milosavljevic92/aquadecor-embedded/aqualight_v3/PCB/aqualight_v3_full.png

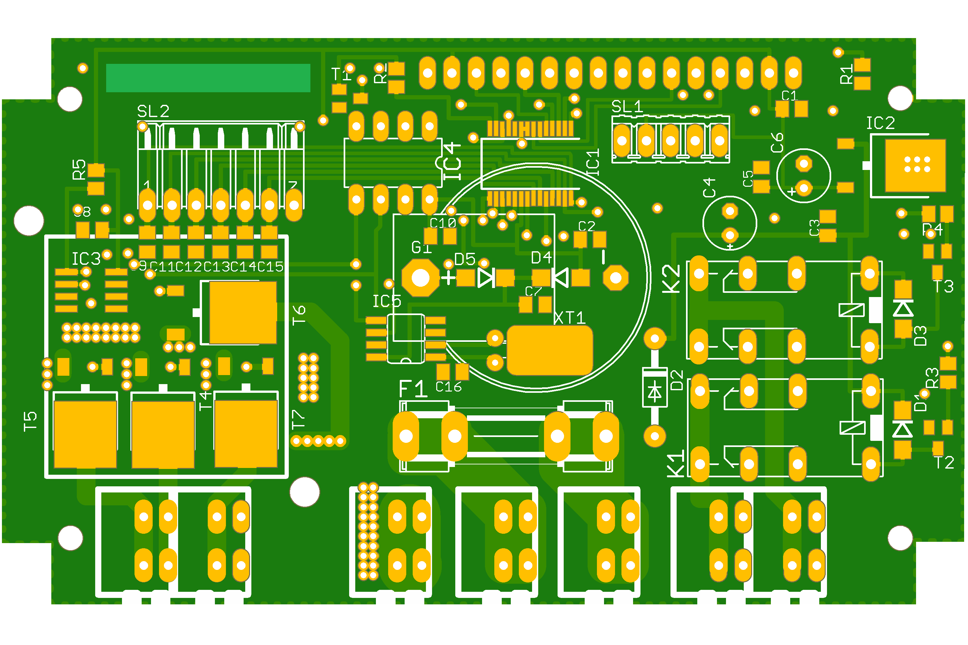
aqualight_v3/PCB/aqualight_v3_full.png
