milosavljevic92/aquadecor-embedded/aqualight_v3/PICTURES/DSC_0008.jpg

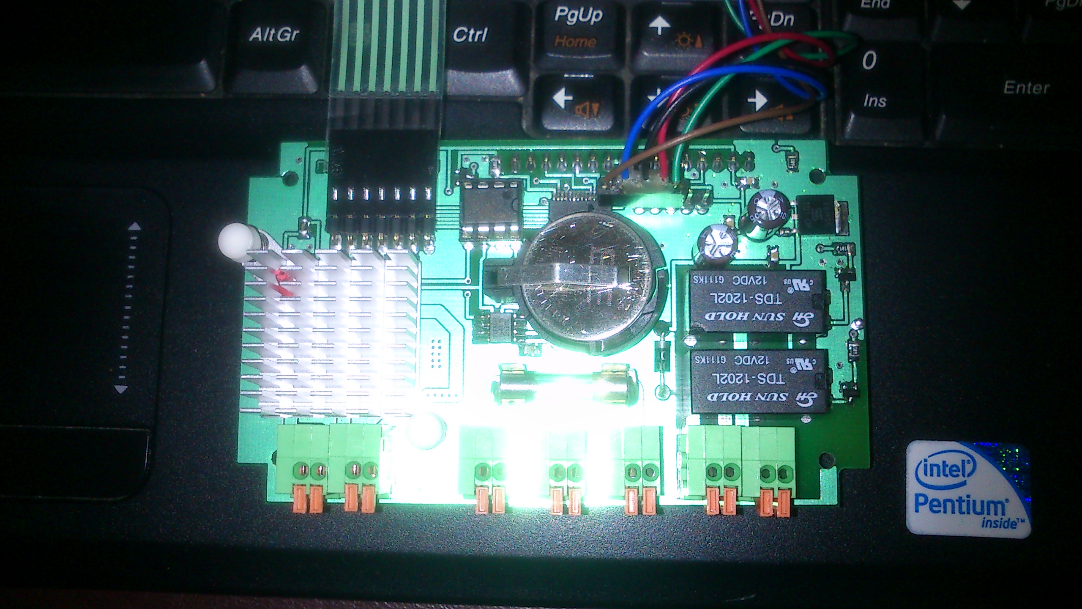
aqualight_v3/PICTURES/DSC_0008.jpg
