milosavljevic92/aquadecor-embedded/aqualight_v3/PICTURES/DSC_0034.jpg

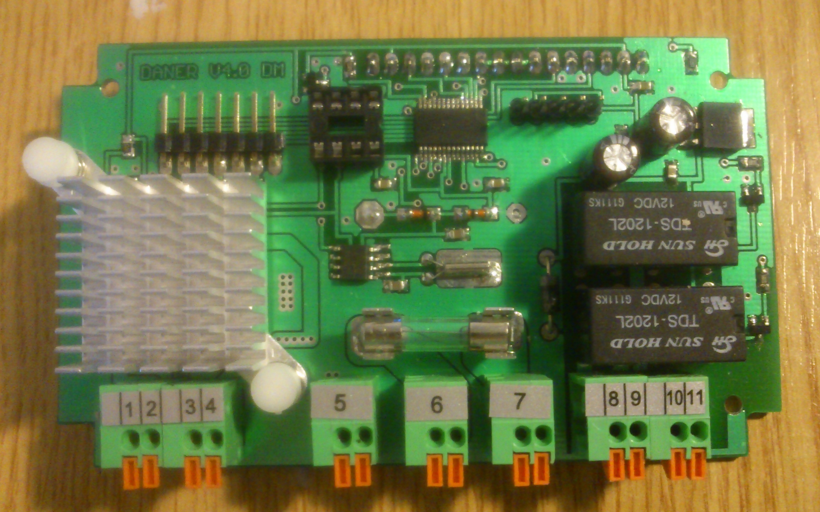
aqualight_v3/PICTURES/DSC_0034.jpg
