milosavljevic92/aquadecor-embedded/aqualight_v3/PICTURES/DSC_0325.jpg

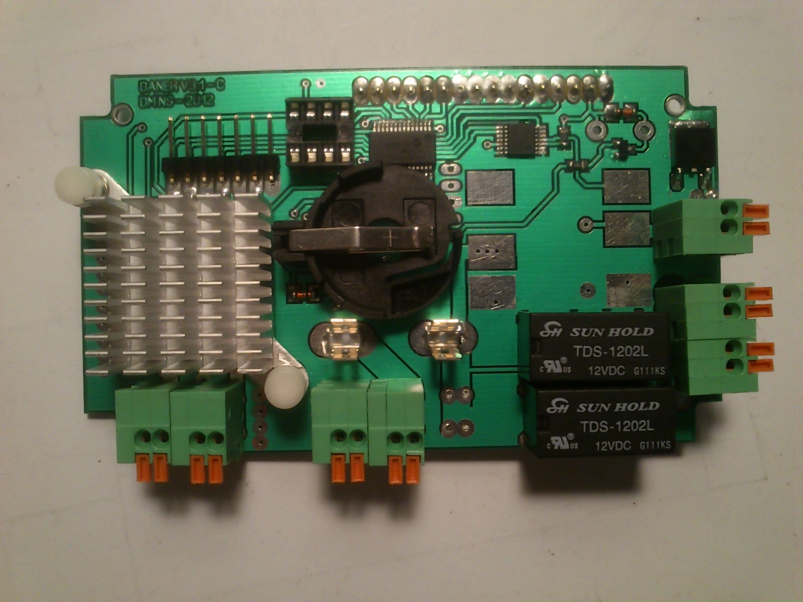
aqualight_v3/PICTURES/DSC_0325.jpg
