milosavljevic92/aquadecor-embedded/aqualight_v3/aqualight_v3_part_list.xlsx

 | Type | Part name | Quantity
IC
1 | IC | PIC18F25k22 SSOP | 1 | 0.00 Din.
2 | IC | PCF8563 SO8 | 1
3 | IC | LM75 SO8 | 1
4 | IC | 24C64 DIP | 1
SMD PART
5 | IC | 78M05 TO252 | 1
6 | Resistor | SMD0805 680 Ohm | 4
7 | Diod | SMD0805 1n41418 | 4
8 | Resistor | SMD0805 4,7k | 1
9 | Transistor | SMD BC517 | 3
10 | Capacitor | SMD0805 100nF | 11
11 | Mosfet | IRLR 8721 TO252 | 4
12 | Capacitor | SMD0805 12Pf | 1
Other part
13 | Battery | CR2032 | 1
14 | Battery holder | Battery holder CR2032 | 1
15 | Diod | 1N4007 | 1
16 | Capacitor | 100uF / 16v ELKO | 2
17 | Relay | Relay HJR1-2C-L-12VDC 2XU 12V 2A 720R | 2
18 | Crystal | Crystal 32,768kHz 2x6 mm | 1
19 | Dil | Chip 8pin DIL8 | 1
20 | Fuse | Fuse fast 10A | 1
21 | Fuse holder | Metal fuse holder - one side | 2
22 | Connector | 2.54 male connector 1x7 angle | 1
23 | Connector | 2.54 male connector 1x5 | 1
24 | Connector | 2.54 male connector 1x16 | 1
25 | Disply | LCD display HD44780 2x16chr + blue backlight | 1
26 | Connector | Connector 2.54 screwless | 7
27 | PCB | PCB 100x60mm double-side | 1
28 | Heatsink | Heatsink Al 26x26mm with spring | 1
