milosavljevic92/aquadecor-embedded/aqualight_v3/PCB/aqualight_v3_full.dxf

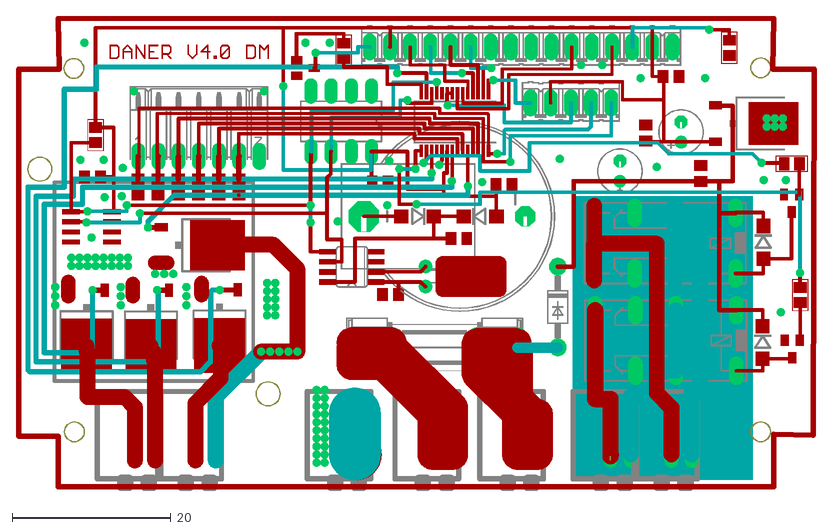
[picture p7: CAD file, 2026-06-04]
aqualight_v3/PCB/aqualight_v3_full.dxf
100.7 x 59.7
