milosavljevic92/aquadecor-embedded/aqualight_v3/Usermanual/MENU_TREE.pdf

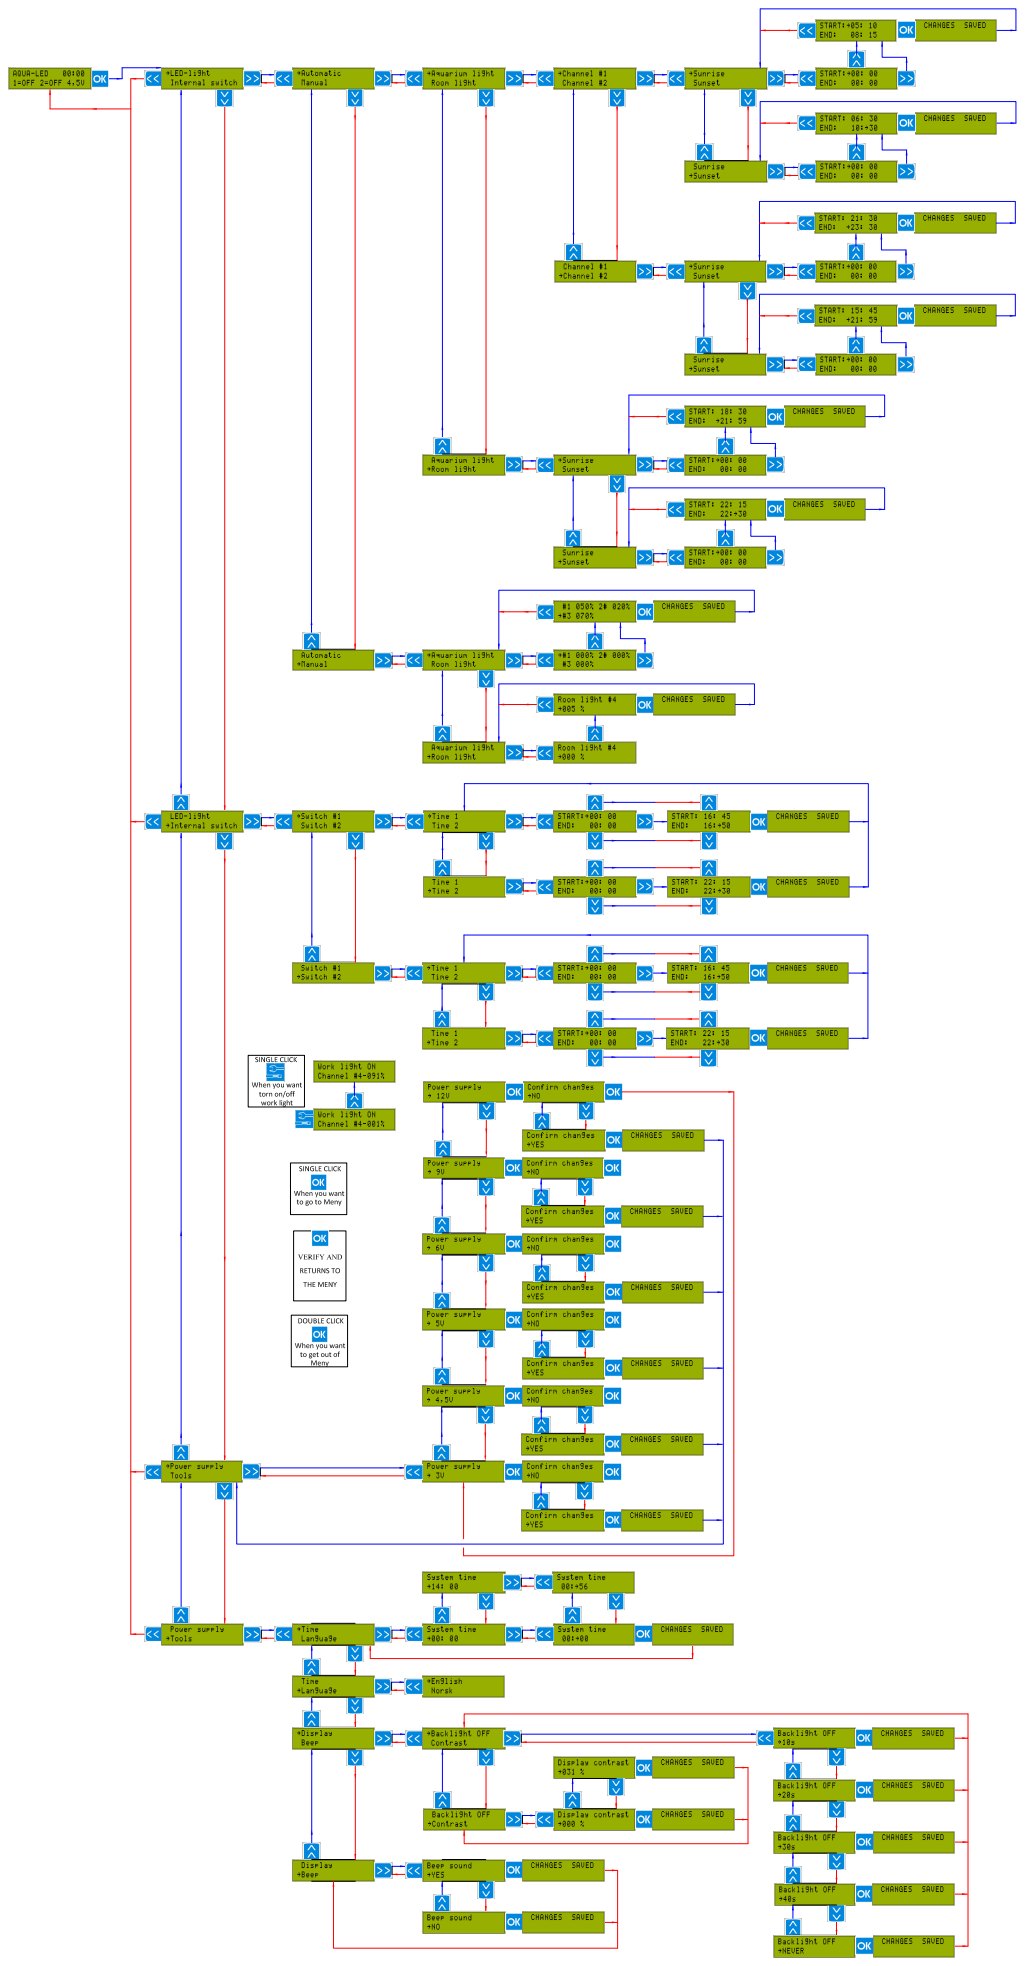
[picture p8: page 1]
