milosavljevic92/aquadecor-embedded/(list of files, drawings)

Other design files:
aqualight_v1/PCB/aqualight_v1_MAIN_pcb.LAY
aqualight_v2/PCB/aqualight_v2_LCD_pcb.LAY
aqualight_v2/PCB/aqualight_v2_MAIN_v2_pcb.LAY
aqualight_v3/Proteus-Simulation/Sim_aqualight_v3_menu.DSN
