milosavljevic92/aquadecor-embedded/aqualight_v3/PCB/aqualight_v3_full.brd

## EAGLE design aqualight_v3/PCB/aqualight_v3_full.brd (2026-06-04)

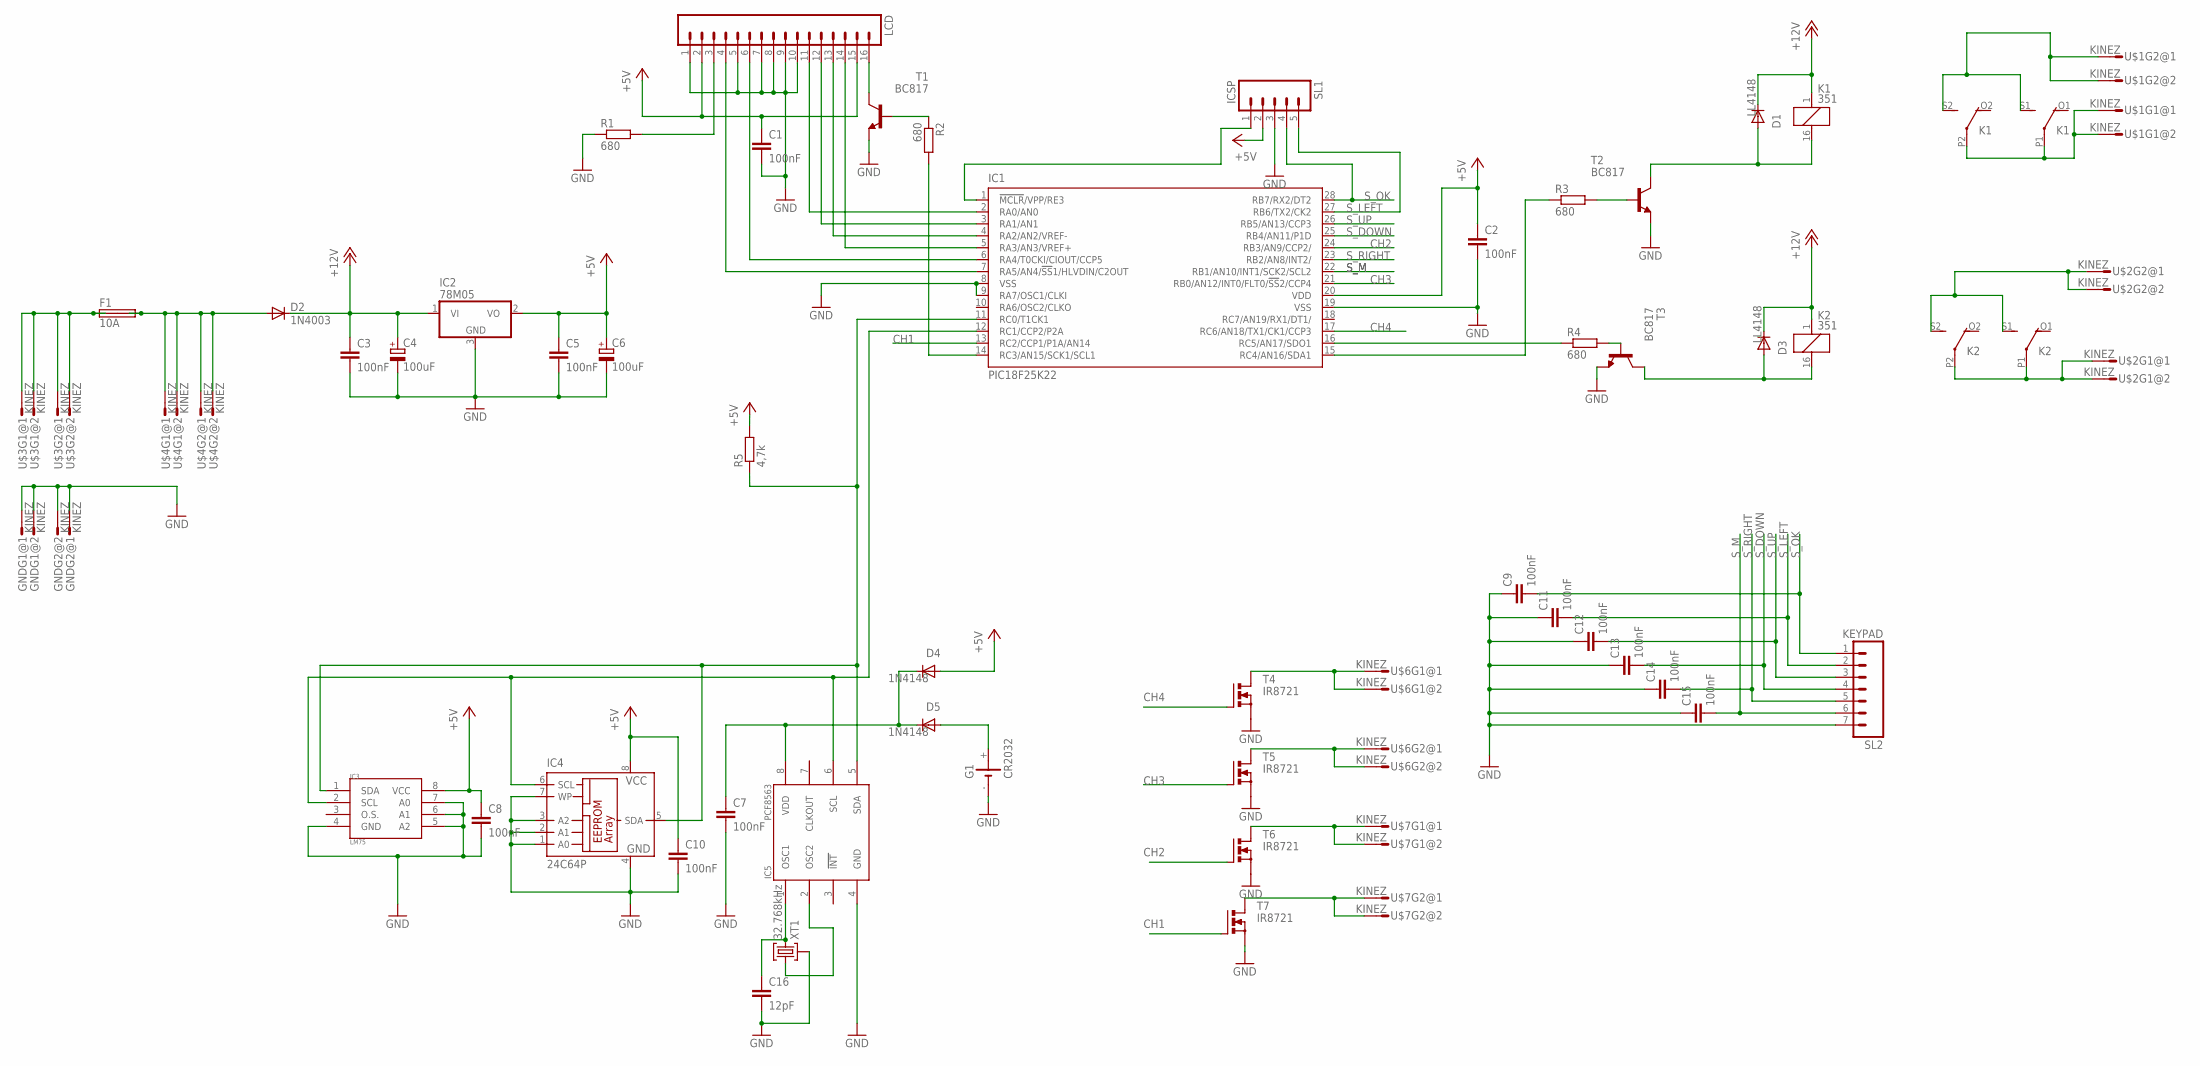
[picture p9: schematic aqualight_v3_full.sch]

Parts:
C1, C2, C3, C5, C7, C8, C9, C10, C11, C12, C13, C14, C15: 100nF; C0805K
C4: 100uF; E2,5-6E
C6: 100uF; E2,5-6
C16: 12pF; C0805K
D1, D3: LL4148; DO214BA
D2: 1N4003; DO41-10
D4, D5: 1N4148; DO214BA
F1: 10A; SHK20L
G1: CR2032
GND: KINEZ
IC1: PIC18F25K22; SSOP28
IC2: 78M05; TO252
IC3: LM75; SO08
IC4: 24C64P; DIL8
IC5: PCF8563; SO08
K1, K2: 351
LCD: M16; 16P
R1, R2, R3, R4: 680; M0805
R5: 4,7k; M0805
SL1: ICSP; 05P
SL2: KEYPAD; 07PA
T1, T2, T3: BC817; SOT23-BEC
T4, T5, T6, T7: IR8721; TO252
U$1, U$2, U$3, U$4, U$6, U$7: KINEZ
XT1: 32.768kHz; XTMINI

Connections:
+5V: C1.1, C2.1, C5.1, C6.+, C8.1, C10.1, D4.A, IC1.20 (VDD), IC2.2 (VO), IC3.8 (VCC), IC4.8 (VCC), LCD.2, LCD.15, R5.2, SL1.2
+12V: C3.1, C4.+, D1.C, D2.C, D3.C, IC2.1 (VI), K1.1, K2.1
CH1: IC1.13 (RC2/CCP1/P1A/AN14), T7.1 (G)
CH2: IC1.24 (RB3/AN9/CCP2/), T6.1 (G)
CH3: IC1.21 (RB0/AN12/INT0/FLT0/!SS!2/CCP4), T5.1 (G)
CH4: IC1.17 (RC6/AN18/TX1/CK1/CCP3), T4.1 (G)
GND: C1.2, C2.2, C3.2, C4.-, C5.2, C6.-, C7.2, C8.2, C9.1, C10.2, C11.1, C12.1, C13.1, C14.1, C15.1, C16.2, G1.-, GND.1, GND.2, GND.3, GND.4, IC1.8 (VSS), IC1.9 (RA7/OSC1/CLKI), IC1.19 (VSS), IC2.3 (GND), IC3.4 (GND), IC3.5 (A2), IC3.6 (A1), IC3.7 (A0), IC4.1 (A0), IC4.2 (A1), IC4.3 (A2), IC4.4 (GND), IC4.7 (WP), IC5.4 (GND), LCD.1, LCD.5, LCD.7, LCD.8, LCD.9, LCD.10, R1.1, SL1.3, SL2.7, T1.E, T2.E, T3.E, T4.3 (S), T5.3 (S), T6.3 (S), T7.3 (S), XT1.P$3 (3)
unnamed: D5.A, G1.+
unnamed: K1.S1 (S), K1.S2 (S), U$1.3, U$1.4
unnamed: K2.P1, K2.P2, U$2.1, U$2.2
unnamed: F1.1A, F1.1B, U$3.1, U$3.2, U$3.3, U$3.4
unnamed: D2.A, F1.2A, F1.2B, U$4.1, U$4.2, U$4.3, U$4.4
unnamed: IC1.15 (RC4/AN16/SDA1), R3.1
unnamed: IC5.2 (OSC2), XT1.P$1 (1)
unnamed: IC1.11 (RC0/T1CK1), IC3.1 (SDA), IC4.5 (SDA), IC5.5 (SDA), R5.1
unnamed: IC1.12 (RC1/CCP2/P2A), IC3.2 (SCL), IC4.6 (SCL), IC5.6 (SCL)
unnamed: C7.1, D4.C, D5.C, IC5.8 (VDD)
unnamed: IC1.2 (RA0/AN0), LCD.11
unnamed: IC1.3 (RA1/AN1), LCD.12
unnamed: IC1.4 (RA2/AN2/VREF-), LCD.13
unnamed: IC1.5 (RA3/AN3/VREF+), LCD.14
unnamed: IC1.6 (RA4/T0CKI/CIOUT/CCP5), LCD.6
unnamed: T5.2 (D), U$6.3, U$6.4
unnamed: IC1.7 (RA5/AN4/!SS!1/HLVDIN/C2OUT), LCD.4
unnamed: LCD.3, R1.2
unnamed: T6.2 (D), U$7.1, U$7.2
unnamed: T7.2 (D), U$7.3, U$7.4
unnamed: D1.A, K1.16 (2), T2.C
unnamed: C16.1, IC5.1 (OSC1), XT1.P$2 (2)
unnamed: D3.A, K2.16 (2), T3.C
unnamed: LCD.16, T1.C
unnamed: R4.2, T3.B
unnamed: R3.2, T2.B
unnamed: K1.P1, K1.P2, U$1.1, U$1.2
unnamed: IC1.16 (RC5/AN17/SDO1), R4.1
unnamed: R2.1, T1.B
unnamed: IC1.14 (RC3/AN15/SCK1/SCL1), R2.2
unnamed: T4.2 (D), U$6.1, U$6.2
unnamed: IC1.1 (!MCLR!/VPP/RE3), SL1.1
SWITCH2_IN: K2.S1 (S), K2.S2 (S), U$2.3, U$2.4
S_DOWN: C13.2, IC1.25 (RB4/AN11/P1D), SL2.4
S_LEFT: C11.2, IC1.27 (RB6/TX2/CK2), SL1.5, SL2.2
S_M: C15.2, IC1.22 (RB1/AN10/INT1/SCK2/SCL2), SL2.6
S_OK: C9.2, IC1.28 (RB7/RX2/DT2), SL1.4, SL2.1
S_RIGHT: C14.2, IC1.23 (RB2/AN8/INT2/), SL2.5
S_UP: C12.2, IC1.26 (RB5/AN13/CCP3), SL2.3

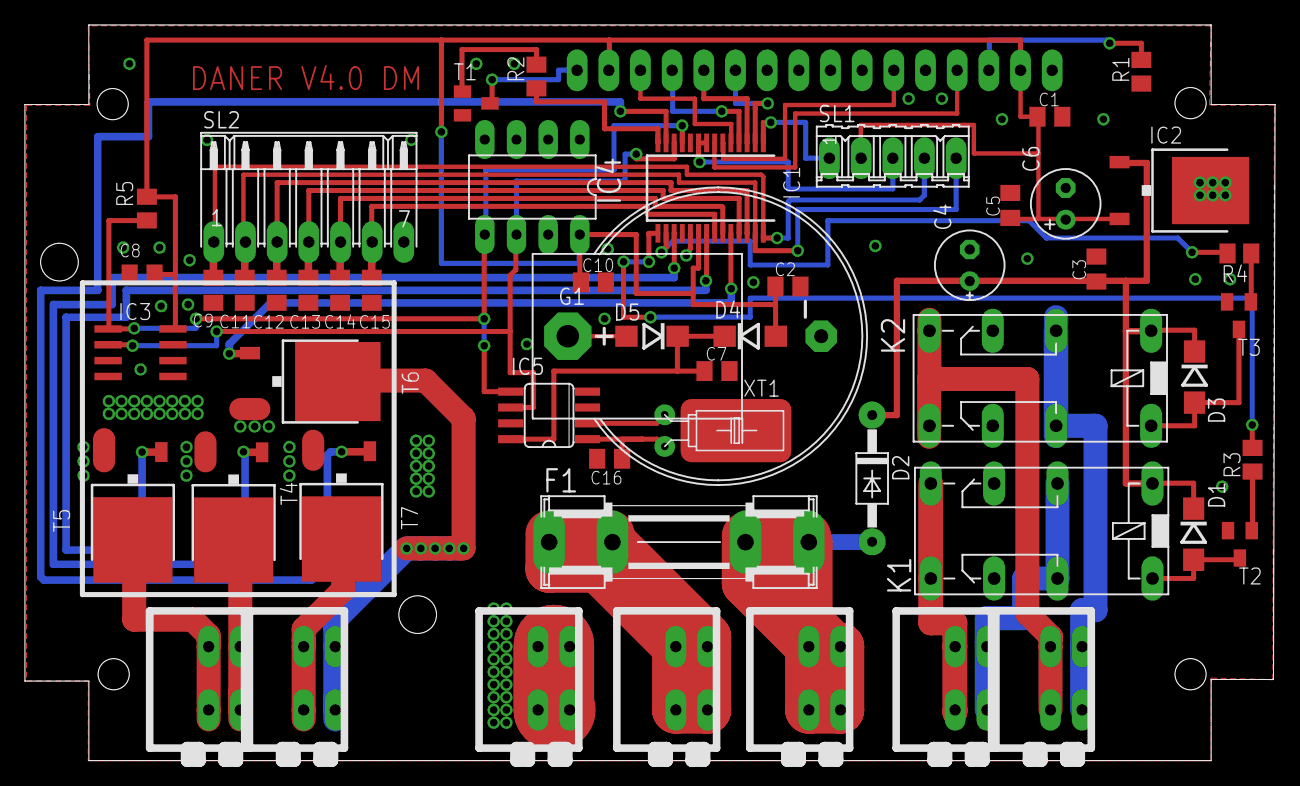
[picture p10: board aqualight_v3_full.brd from above]

Board: 2 copper layers, 100.3 x 59.0 mm, 53 parts (1 on the bottom side), 46 nets.
