milosavljevic92/aquadecor-embedded/(commit log)

2026-06-04 renename staff
    [aqualight_v3_full.brd, aqualight_v3_full.dxf, aqualight_v3_full.sch, aqualight_v3_rev.brd, aqualight_v3_rev.sch]
2026-06-04 remove some files
    [Tablicamemorije.xlsx, eeprom_map.xlsx, translate.xlsx]
